HasanFairuz/mirnov-coil-winder/media/Coil Winding.png

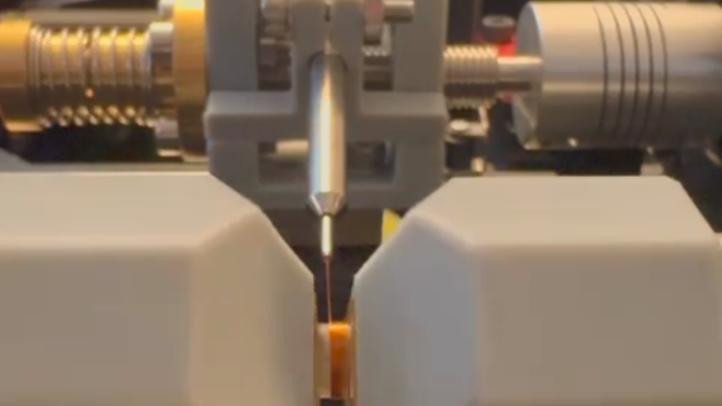
media/Coil Winding.png
