HasanFairuz/mirnov-coil-winder/media/GF Demo.jpg

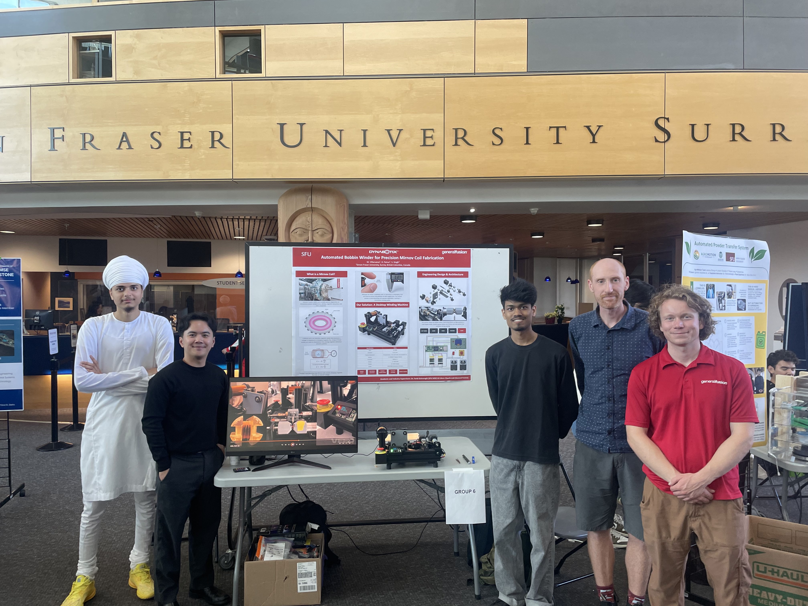
media/GF Demo.jpg
