HasanFairuz/mirnov-coil-winder/docs/BOM_SUMMARY.md

# Major Components — Curated Summary

[← README](../README.md)

This is a **public-facing descriptive overview**, not a reproduction of the source June 2026 procurement BOM, which was marked confidential and included prices, vendors, and preliminary design options.

| Subsystem | Principal components |
|:--|:--|
| Embedded controller | Teensy 4.1 development board |
| Motor drivers | Two operating TMC2209 stepper-driver modules |
| Motion | NEMA 17 spindle and traverse motors |
| Traverse | Lead screw, anti-backlash nut, MGN9 rail and carriage |
| Wire path | Ceramic eyelets, ruby-tipped nozzle, supply spool and passive tension arrangement |
| Operator UI | I²C SSD1306 OLED, pushbuttons and status LEDs |
| Safety/reference | Emergency-stop input and homing limit switch |
| Structure | Aluminum extrusion and printed mechanical mounts |

Component selection, quantity, substitutions and safety circuitry should be confirmed using the actual hardware before procurement or reconstruction. This summary deliberately omits sponsor procurement details and unverified pricing.
