HasanFairuz/mirnov-coil-winder/media/Interface Wiring.png

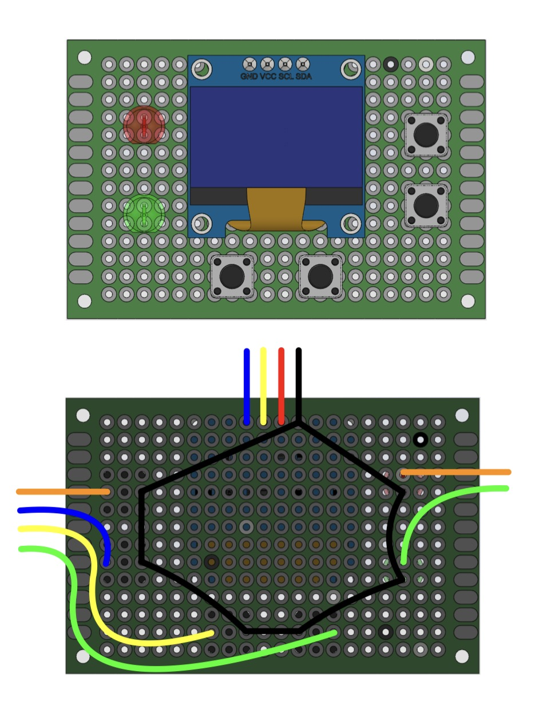
media/Interface Wiring.png
