HasanFairuz/mirnov-coil-winder/media/Soldered Connections.jpg

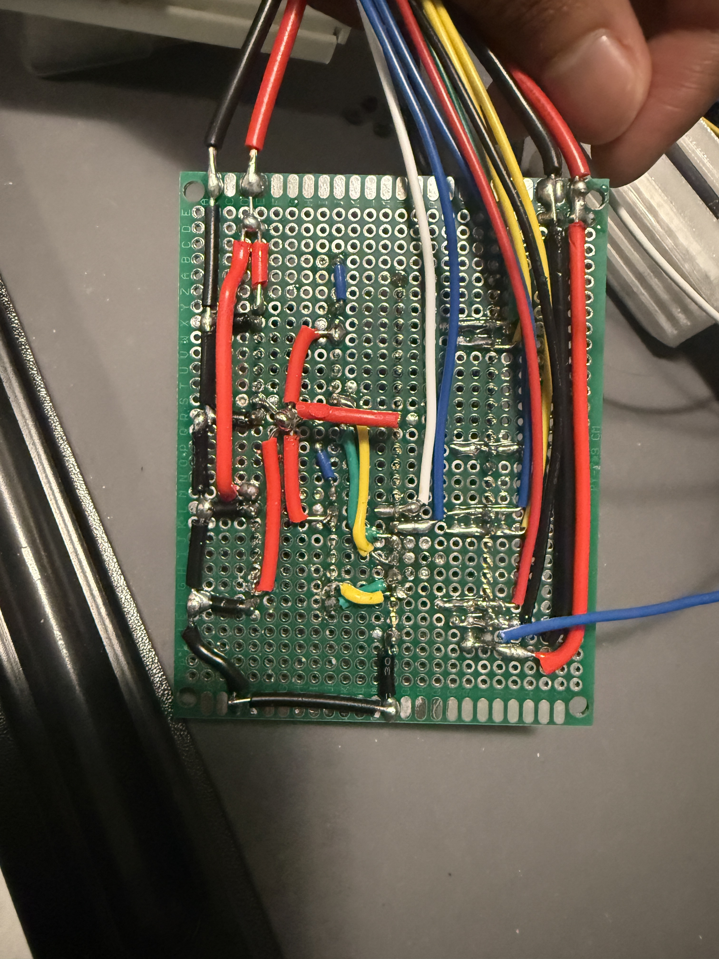
media/Soldered Connections.jpg
